hhhzs/Interactive-Wearable-Healthy-Habits-Monitor/Android code/BlunoBasicDemo-master/README.md

BlunoBasicDemo
=======================

# _Brief_

_Description: This is a basic Demo for Bluno including all the code and executable on Android,IOS and Android.You can easily develop your own with this Demo._

## BLE Details

*DF Robot Service:*
Id: 0000dfb0-0000-1000-8000-00805f9b34fb

*DF Robot Characteristics:*
Name: Serial Port
Id: 0000dfb1-0000-1000-8000-00805f9b34fb
  
Name: Command
Id: 0000dfb2-0000-1000-8000-00805f9b34fb

*DF Robot Descriptors:*
(**same for both characteristics**)
Name: Read
Name: WriteWithoutResponse
Name: Write
Name: Notify

## Project Setup

_to start working on the project, take a look at the following steps_ 

1. _What dependencies does it have and how do I install them?_

You may need the Arduino IDE<br />  
If you want to recompile the application on Android device, you will need the eclipse with Android bundle.<br />  
If you want to recompile the application on IOS device, you will need xcode.<br />  

2. _How can I see the project working before I change anything?_

Go to this site for tutorial:<br />  
http://www.dfrobot.com/wiki/index.php/Bluno_SKU:DFR0267

3. _What hardware I need and where to get it?_
You will need:
[BLUNO ×1](http://www.dfrobot.com/index.php?route=product/product&product_id=1044#.UoyIUpH7k8M)<br />  
Android 4.3+ Devices with BLE or IOS 7.0+ Devices<br />  
[Accessory Shield with Arduino ×1](http://www.dfrobot.com/index.php?route=product/product&product_id=1045#.UoyJtZH7k8M)<br />  
[Micro USB cable x1](http://www.dfrobot.com/index.php?route=product/product&filter_name=micro%20usb&product_id=1076#.Uv2K0nnF9H0)<br />  

You can get it at<br />  
DFRobot.com<br />  

IOS devices or Android devices with 4.3+ ROM<br />  

4. _How t start?_

Go to this site for more tutorial:<br />  
http://www.dfrobot.com/wiki/index.php/Bluno_SKU:DFR0267

## Contributing changes

- _Join the forums for dev discussions_
- _More information at DFRobot technical support_
- _"Please open github issues"_

## License

_GPLv3_
